L-iness/AutonomousHenhouseProject/README.md

# AutonomousHenhouseProject

This is a project from IMT Atlantique done by first year students.

The Arduino code is for the motor of a henhouse's door using an Arduino UNO board, a RTC DS1307, a motor, a shield motor and two sensors.
