L-iness/AutonomousHenhouseProject/Plan_poulailler.stl

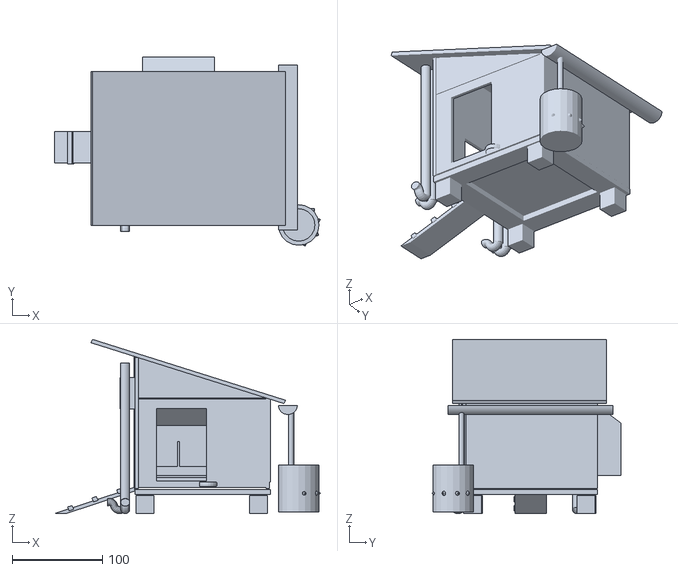
[picture p3: CAD file, 2021-06-09]
Plan_poulailler.stl
295.1 x 210.0 x 193.3
